mjodonnell5/ECE477-SeniorDesign-7/EInkDisplay-PCB/ECE477-SeniorDesign/ECE477-SeniorDesign.kicad_pcb

## KiCad design EInkDisplay-PCB/ECE477-SeniorDesign/ECE477-SeniorDesign.kicad_pcb (2025-03-13)

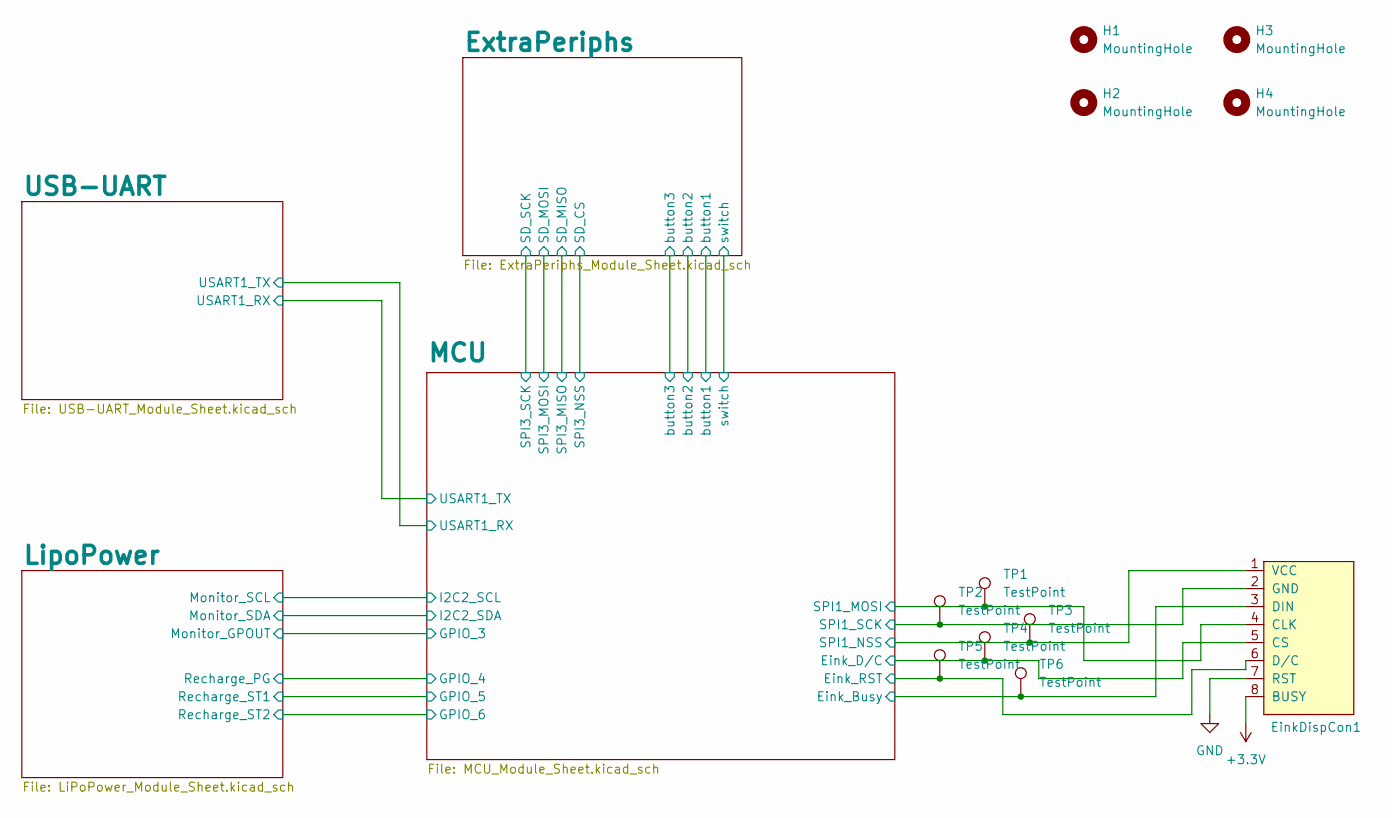
[picture p1: schematic ECE477-SeniorDesign.kicad_sch]

Parts:
EinkDispCon1: PinHeader_1x08_P2.54mm_Vertical
H1, H2, H3, H4: MountingHole; MountingHole_2.1mm
TP1, TP2, TP3, TP4, TP5, TP6: TestPoint; TestPoint_Pad_D2.0mm

Connections:
+3.3V: EinkDispCon1.8 (BUSY); also elsewhere on the board
/MCU/Eink_Busy: EinkDispCon1.3 (DIN), TP6.1; also elsewhere on the board
/MCU/Eink_D/C: EinkDispCon1.5 (CS), TP4.1; also elsewhere on the board
/MCU/Eink_RST: EinkDispCon1.6 (D/C), TP5.1; also elsewhere on the board
/MCU/SPI1_MOSI: EinkDispCon1.4 (CLK), TP1.1; also elsewhere on the board
/MCU/SPI1_NSS: EinkDispCon1.1 (VCC), TP3.1; also elsewhere on the board
/MCU/SPI1_SCK: EinkDispCon1.2 (GND), TP2.1; also elsewhere on the board
GND: EinkDispCon1.7 (RST); also elsewhere on the board

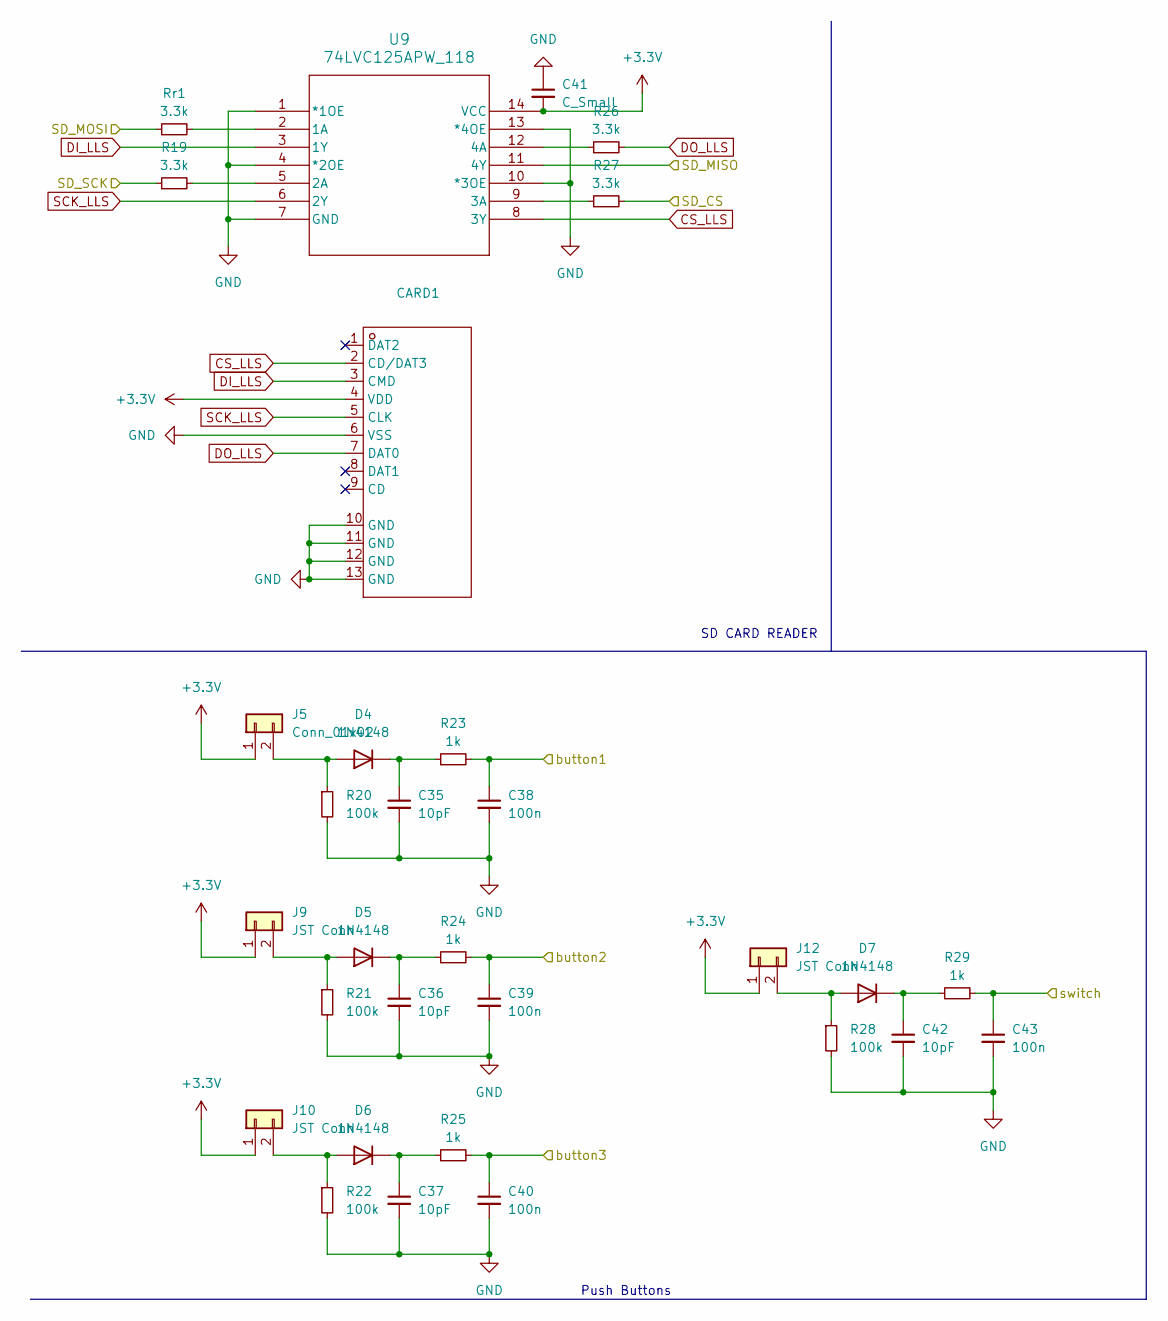
[picture p2: schematic ExtraPeriphs_Module_Sheet.kicad_sch]

Parts:
C35, C36, C37, C42: 10pF; C_0805_2012Metric_Pad1.18x1.45mm_HandSolder
C38, C39, C40, C43: 100n; C_0805_2012Metric_Pad1.18x1.45mm_HandSolder
C41: C_Small; C_0805_2012Metric_Pad1.18x1.45mm_HandSolder
CARD1: SD_reader_comp; Manufacturer Part XKTF-015-N; LCSC Part Name 自弹式 MicroSD卡(TF卡) 卡座
D4, D5, D6, D7: 1N4148; D_DO-35_SOD27_P7.62mm_Horizontal
J5: Conn_01x02; SolderWire-0.1sqmm_1x02_P3.6mm_D0.4mm_OD1mm
J9, J10, J12: JST Conn; SolderWire-0.1sqmm_1x02_P3.6mm_D0.4mm_OD1mm
R19, R26, R27: 3.3k; R_0805_2012Metric_Pad1.20x1.40mm_HandSolder
R20, R21, R22, R28: 100k; R_0805_2012Metric_Pad1.20x1.40mm_HandSolder
R23, R24, R25, R29: 1k; R_0805_2012Metric_Pad1.20x1.40mm_HandSolder
Rr1: 3.3k; R_0805_2012Metric_Pad1.20x1.40mm_HandSolder
U9: 74LVC125APW_118; 74LVC

Connections:
+3.3V: C41.2, CARD1.4 (VDD), J5.1, J9.1, J10.1, J12.1, U9.14 (VCC); also elsewhere on the board
/ExtraPeriphs/SD_CS: R27.2; also elsewhere on the board
/ExtraPeriphs/SD_MISO: U9.11 (4Y); also elsewhere on the board
/ExtraPeriphs/SD_MOSI: Rr1.1; also elsewhere on the board
/ExtraPeriphs/SD_SCK: R19.1; also elsewhere on the board
/ExtraPeriphs/button1: C38.1, R23.2; also elsewhere on the board
/ExtraPeriphs/button2: C39.1, R24.2; also elsewhere on the board
/ExtraPeriphs/button3: C40.1, R25.2; also elsewhere on the board
/ExtraPeriphs/switch: C43.1, R29.2; also elsewhere on the board
CS_LLS: CARD1.2 (CD/DAT3), U9.8 (3Y)
DI_LLS: CARD1.3 (CMD), U9.3 (1Y)
DO_LLS: CARD1.7 (DAT0), R26.2
GND: C35.2, C36.2, C37.2, C38.2, C39.2, C40.2, C41.1, C42.2, C43.2, CARD1.6 (VSS), CARD1.10 (GND), CARD1.11 (GND), CARD1.12 (GND), CARD1.13 (GND), R20.2, R21.2, R22.2, R28.2, U9.1 (*1OE), U9.4 (*2OE), U9.7 (GND), U9.10 (*3OE), U9.13 (*4OE); also elsewhere on the board
unnamed: D4.2 (A), J5.2, R20.1
unnamed: C35.1, D4.1 (K), R23.1
unnamed: D5.2 (A), J9.2, R21.1
unnamed: C36.1, D5.1 (K), R24.1
unnamed: D6.2 (A), J10.2, R22.1
unnamed: C37.1, D6.1 (K), R25.1
unnamed: D7.2 (A), J12.2, R28.1
unnamed: C42.1, D7.1 (K), R29.1
unnamed: Rr1.2, U9.2 (1A)
unnamed: R19.2, U9.5 (2A)
unnamed: R27.1, U9.9 (3A)
unnamed: R26.1, U9.12 (4A)
SCK_LLS: CARD1.5 (CLK), U9.6 (2Y)

Notes on the sheet:
SD CARD READER
Push Buttons

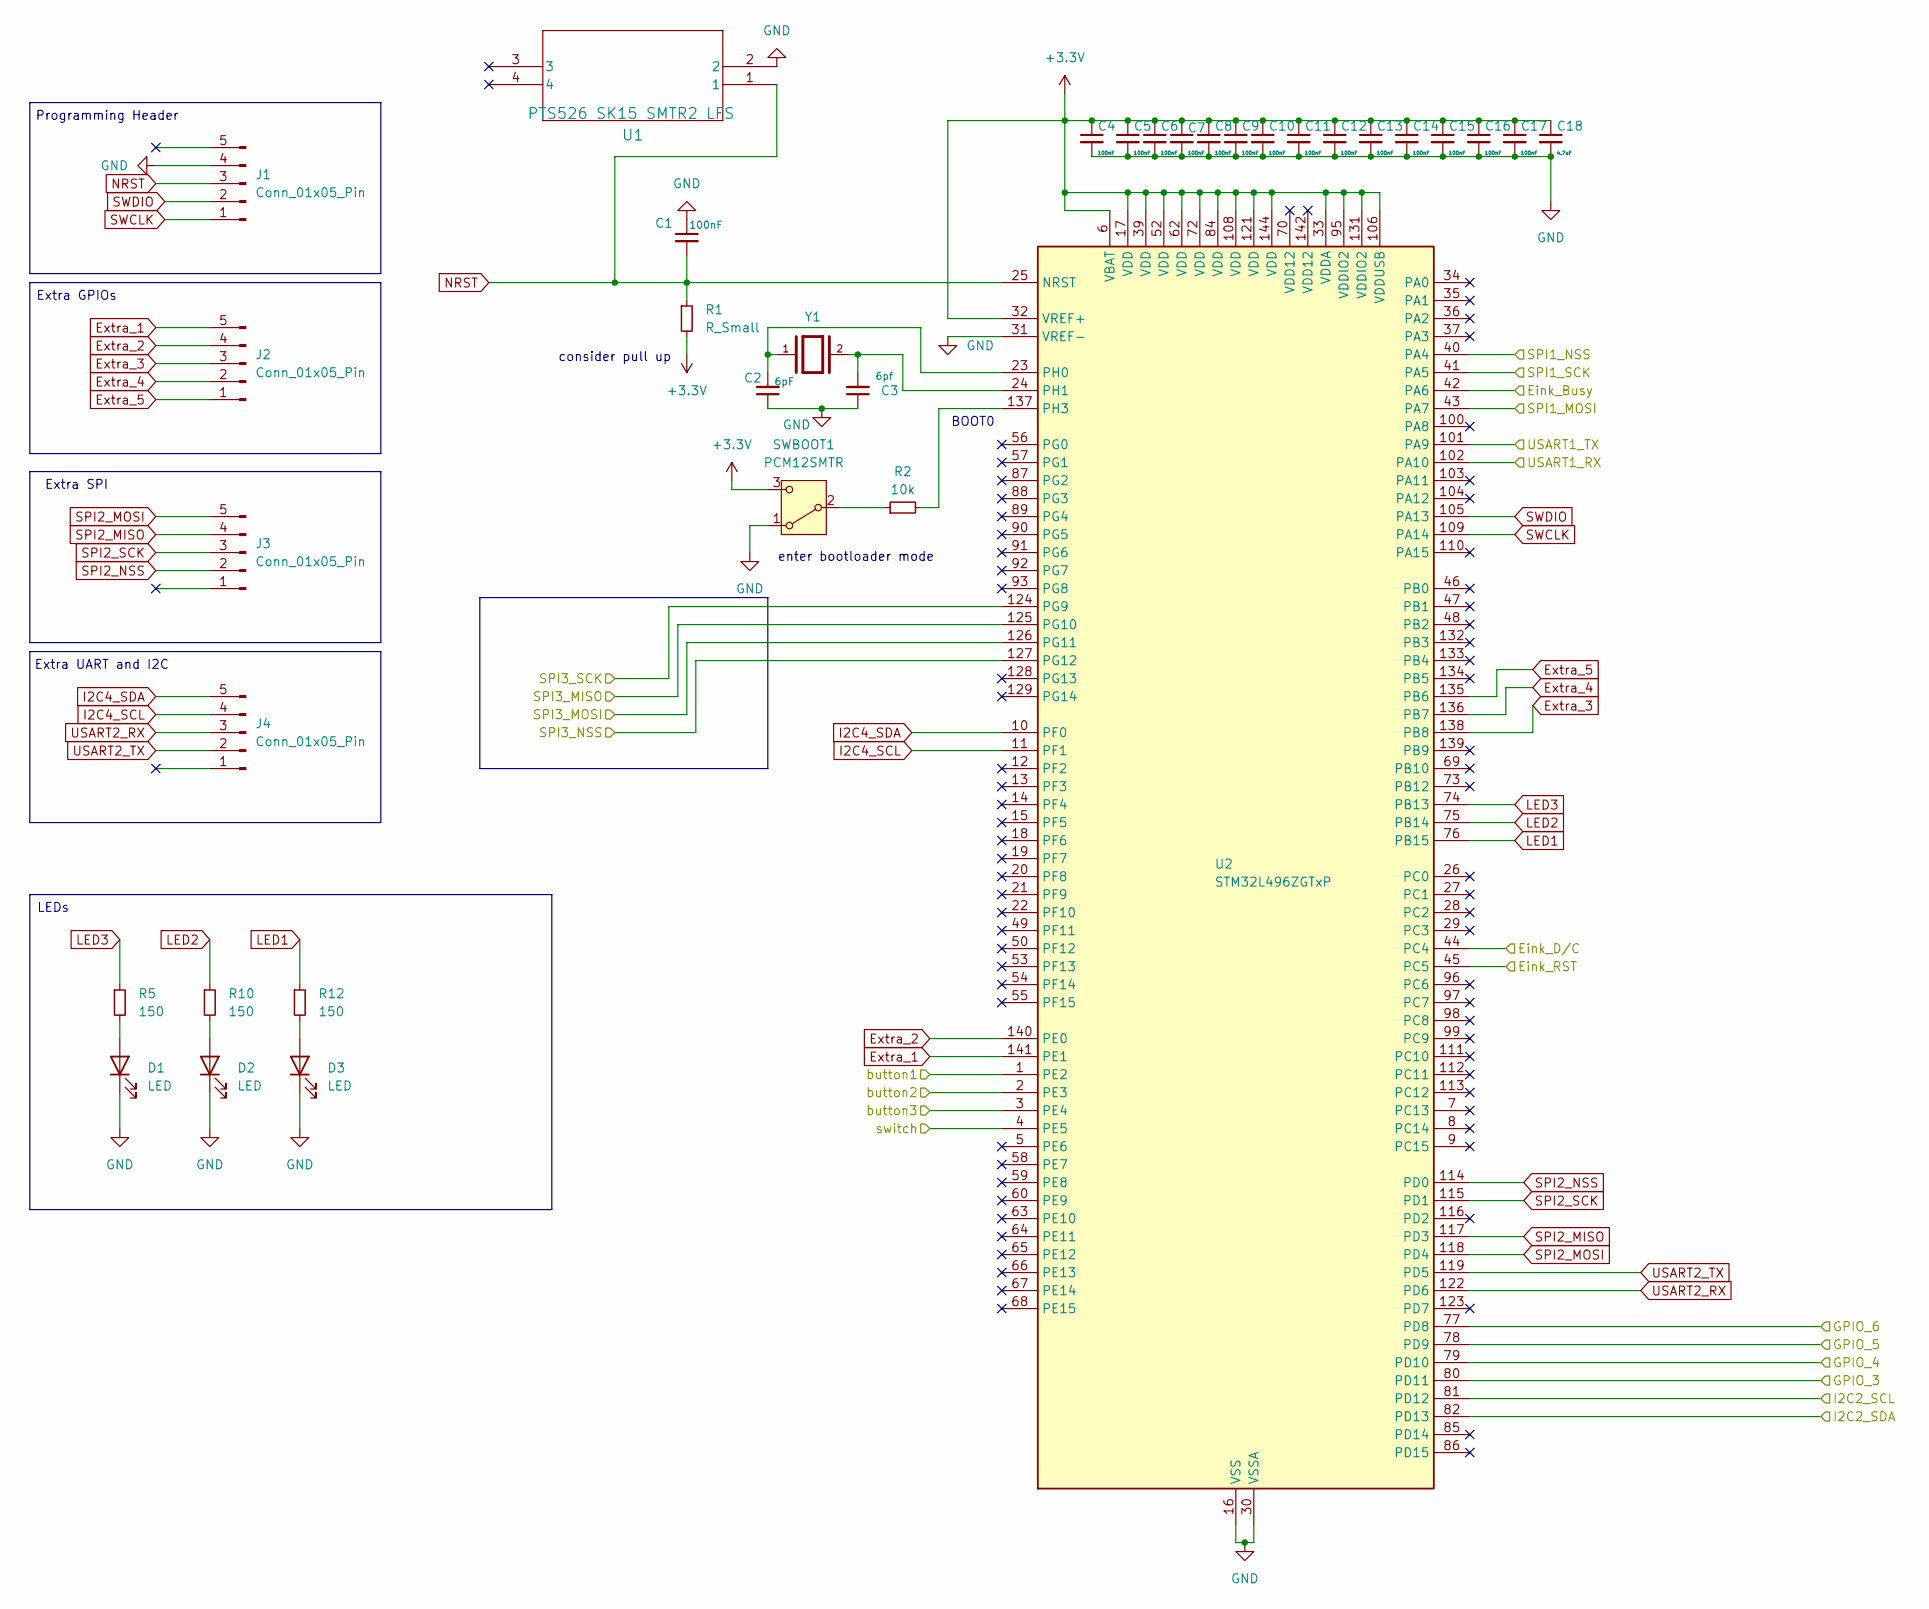
[picture p3: schematic MCU_Module_Sheet.kicad_sch]

Parts:
C1, C4, C5, C6, C7, C8, C9, C10, C11, C12, C13, C14, C15, C16, C17: 100nF; C_0805_2012Metric_Pad1.18x1.45mm_HandSolder
C2: 6pF; C_0805_2012Metric_Pad1.18x1.45mm_HandSolder
C3: 6pf; C_0805_2012Metric_Pad1.18x1.45mm_HandSolder
C18: 4.7uF; C_0805_2012Metric_Pad1.18x1.45mm_HandSolder
D1, D2, D3: LED; LED_0603_1608Metric
J1, J2, J3, J4: Conn_01x05_Pin; PinHeader_1x05_P2.54mm_Vertical
R1: R_Small; R_0805_2012Metric_Pad1.20x1.40mm_HandSolder
R2: 10k; R_0603_1608Metric_Pad0.98x0.95mm_HandSolder
R5, R10, R12: 150; R_0805_2012Metric_Pad1.20x1.40mm_HandSolder
SWBOOT1: PCM12SMTR; SW_SPDT_PCM12
U1: PTS526 SK15 SMTR2 LFS; PTS256
U2: STM32L496ZGTxP; LQFP-144_20x20mm_P0.5mm
Y1: CM9V-T1A-32.768KHZ-7PF-100PPM-TA-QC; PARTREV 8.0/10.2016

Connections:
+3.3V: C4.1, C5.1, C6.1, C7.1, C8.1, C9.1, C10.1, C11.1, C12.1, C13.1, C14.1, C15.1, C16.1, C17.1, C18.1, R1.2, SWBOOT1.3 (C), U2.6 (VBAT), U2.17 (VDD), U2.32 (VREF+), U2.33 (VDDA), U2.39 (VDD), U2.52 (VDD), U2.62 (VDD), U2.72 (VDD), U2.84 (VDD), U2.95 (VDDIO2), U2.106 (VDDUSB), U2.108 (VDD), U2.121 (VDD), U2.131 (VDDIO2), U2.144 (VDD); also elsewhere on the board
/ExtraPeriphs/SD_CS: U2.127 (PG12); also elsewhere on the board
/ExtraPeriphs/SD_MISO: U2.125 (PG10); also elsewhere on the board
/ExtraPeriphs/SD_MOSI: U2.126 (PG11); also elsewhere on the board
/ExtraPeriphs/SD_SCK: U2.124 (PG9); also elsewhere on the board
/ExtraPeriphs/button1: U2.1 (PE2); also elsewhere on the board
/ExtraPeriphs/button2: U2.2 (PE3); also elsewhere on the board
/ExtraPeriphs/button3: U2.3 (PE4); also elsewhere on the board
/ExtraPeriphs/switch: U2.4 (PE5); also elsewhere on the board
/LipoPower/Monitor_GPOUT: U2.80 (PD11); also elsewhere on the board
/LipoPower/Monitor_SCL: U2.81 (PD12); also elsewhere on the board
/LipoPower/Monitor_SDA: U2.82 (PD13); also elsewhere on the board
/LipoPower/Recharge_PG: U2.79 (PD10); also elsewhere on the board
/LipoPower/Recharge_ST1: U2.78 (PD9); also elsewhere on the board
/LipoPower/Recharge_ST2: U2.77 (PD8); also elsewhere on the board
/MCU/Eink_Busy: U2.42 (PA6); also elsewhere on the board
/MCU/Eink_D/C: U2.44 (PC4); also elsewhere on the board
/MCU/Eink_RST: U2.45 (PC5); also elsewhere on the board
/MCU/SPI1_MOSI: U2.43 (PA7); also elsewhere on the board
/MCU/SPI1_NSS: U2.40 (PA4); also elsewhere on the board
/MCU/SPI1_SCK: U2.41 (PA5); also elsewhere on the board
/MCU/USART1_RX: U2.102 (PA10); also elsewhere on the board
/MCU/USART1_TX: U2.101 (PA9); also elsewhere on the board
Extra_1: J2.5, U2.141 (PE1)
Extra_2: J2.4, U2.140 (PE0)
Extra_3: J2.3, U2.138 (PB8)
Extra_4: J2.2, U2.136 (PB7)
Extra_5: J2.1, U2.135 (PB6)
GND: C1.1, C2.1, C3.1, C4.2, C5.2, C6.2, C7.2, C8.2, C9.2, C10.2, C11.2, C12.2, C13.2, C14.2, C15.2, C16.2, C17.2, C18.2, D1.1 (K), D2.1 (K), D3.1 (K), J1.4, SWBOOT1.1 (A), U1.2, U2.16 (VSS), U2.30 (VSSA), U2.31 (VREF-), U2.38 (VSS), U2.51 (VSS), U2.61 (VSS), U2.71 (VSS), U2.83 (VSS), U2.94 (VSS), U2.107 (VSS), U2.120 (VSS), U2.130 (VSS), U2.143 (VSS); also elsewhere on the board
I2C4_SCL: J4.4, U2.11 (PF1)
I2C4_SDA: J4.5, U2.10 (PF0)
LED1: R12.1, U2.76 (PB15)
LED2: R10.1, U2.75 (PB14)
LED3: R5.1, U2.74 (PB13)
NRST: C1.2, J1.3, R1.1, U1.1, U2.25 (NRST)
unnamed: D1.2 (A), R5.2
unnamed: D2.2 (A), R10.2
unnamed: D3.2 (A), R12.2
unnamed: R2.1, SWBOOT1.2 (B)
unnamed: C2.2, U2.23 (PH0), Y1.1
unnamed: C3.2, U2.24 (PH1), Y1.2
unnamed: R2.2, U2.137 (PH3)
SPI2_MISO: J3.4, U2.117 (PD3)
SPI2_MOSI: J3.5, U2.118 (PD4)
SPI2_NSS: J3.2, U2.114 (PD0)
SPI2_SCK: J3.3, U2.115 (PD1)
SWCLK: J1.1, U2.109 (PA14)
SWDIO: J1.2, U2.105 (PA13)
USART2_RX: J4.3, U2.122 (PD6)
USART2_TX: J4.2, U2.119 (PD5)

Notes on the sheet:
consider pull up
BOOT0
Extra UART and I2C
Programming Header
enter bootloader mode
Extra SPI
Extra GPIOs
LEDs

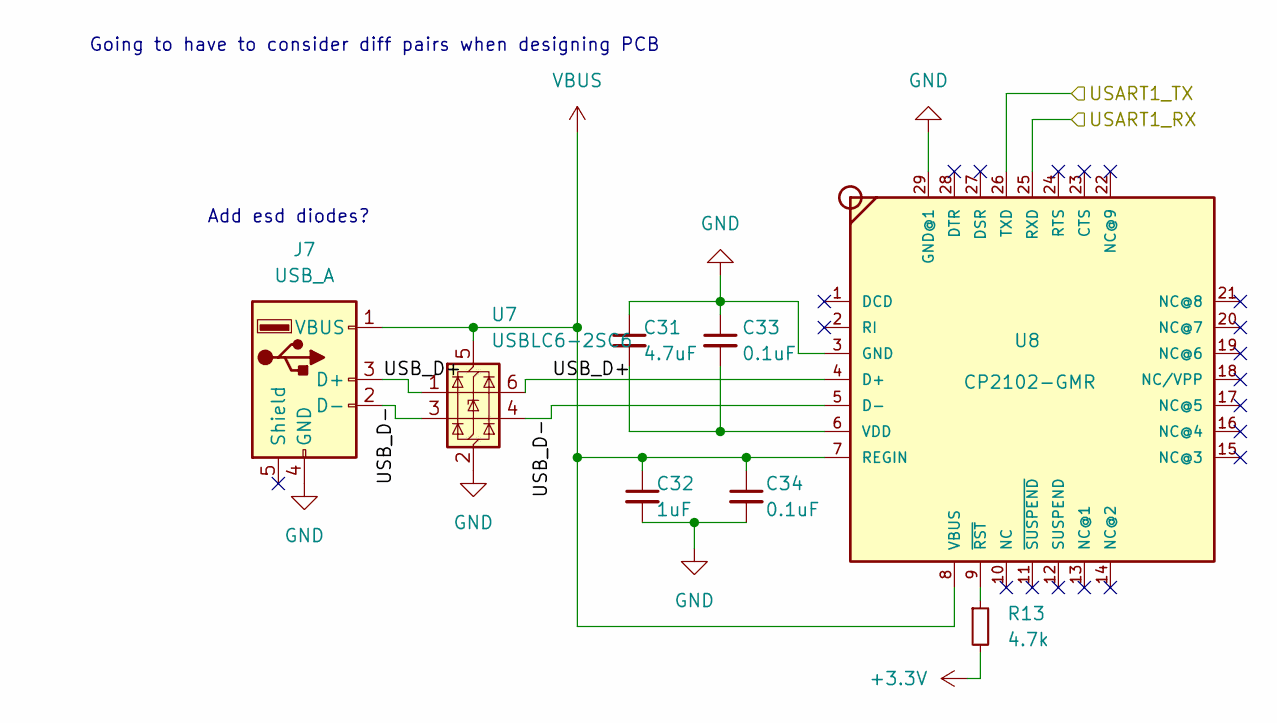
[picture p4: schematic USB-UART_Module_Sheet.kicad_sch]

Parts:
C31: 4.7uF; C_0805_2012Metric_Pad1.18x1.45mm_HandSolder
C32: 1uF; C_0805_2012Metric_Pad1.18x1.45mm_HandSolder
C33, C34: 0.1uF; C_0805_2012Metric_Pad1.18x1.45mm_HandSolder
J7: USB_A; USB_A_Receptacle_GCT_USB1046
R13: 4.7k; R_0805_2012Metric_Pad1.20x1.40mm_HandSolder
U7: USBLC6-2SC6; SOT-23-6
U8: CP2102-GMR; CP2102; MPN CP2102-GMR; LCSC C6568

Connections:
+3.3V: R13.2; also elsewhere on the board
/MCU/USART1_RX: U8.26 (TXD); also elsewhere on the board
/MCU/USART1_TX: U8.25 (RXD); also elsewhere on the board
/USB-UART/USB_D+: J7.3 (D+), U7.1 (I/O1), U7.6 (I/O1), U8.4 (D+)
/USB-UART/USB_D-: J7.2 (D-), U7.3 (I/O2), U7.4 (I/O2), U8.5 (D-)
GND: C31.1, C32.2, C33.1, C34.2, J7.4 (GND), J7.5 (Shield), U7.2 (GND), U8.3 (GND), U8.29 (GND@1); also elsewhere on the board
unnamed: C31.2, C33.2, U8.6 (VDD)
unnamed: R13.1, U8.9 (~RST)
VBUS: C32.1, C34.1, J7.1 (VBUS), U7.5 (VBUS), U8.7 (REGIN), U8.8 (VBUS); also elsewhere on the board

Notes on the sheet:
Add esd diodes?
Going to have to consider diff pairs when designing PCB

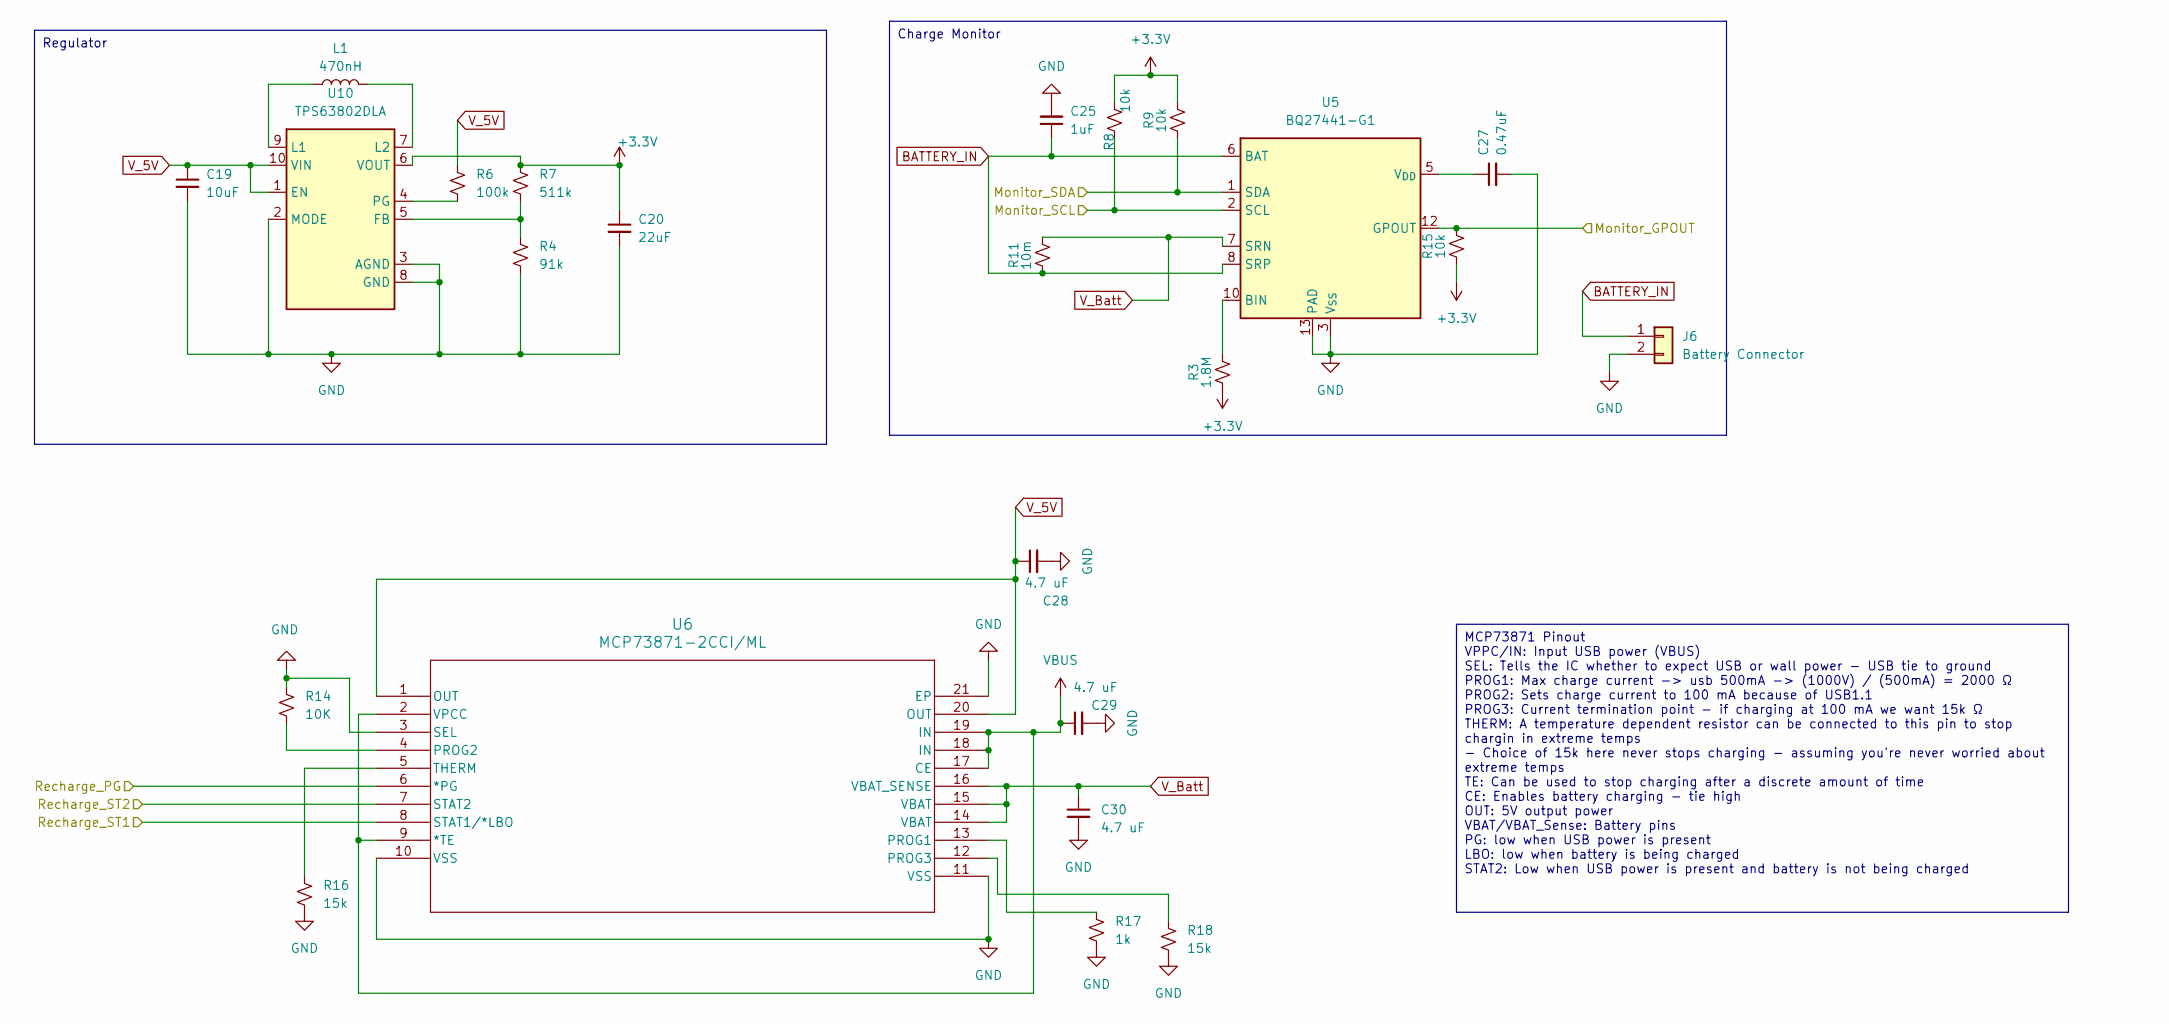
[picture p5: schematic LiPoPower_Module_Sheet.kicad_sch]

Parts:
C19: 10uF; C_0805_2012Metric_Pad1.18x1.45mm_HandSolder
C20: 22uF; C_0805_2012Metric_Pad1.18x1.45mm_HandSolder
C25: 1uF; C_0805_2012Metric_Pad1.18x1.45mm_HandSolder
C27: 0.47uF; C_0805_2012Metric_Pad1.18x1.45mm_HandSolder
C28, C29, C30: 4.7 uF; C_0805_2012Metric_Pad1.18x1.45mm_HandSolder
J6: Battery Connector; JST_PH_S2B-PH-SM4-TB_1x02-1MP_P2.00mm_Horizontal
L1: 470nH; IND_XFL4015_COC-L
R3: 1.8M; R_0805_2012Metric_Pad1.20x1.40mm_HandSolder
R4: 91k; R_0805_2012Metric_Pad1.20x1.40mm_HandSolder
R6: 100k; R_0805_2012Metric_Pad1.20x1.40mm_HandSolder
R7: 511k; R_0805_2012Metric_Pad1.20x1.40mm_HandSolder
R8, R9, R15: 10k; R_0805_2012Metric_Pad1.20x1.40mm_HandSolder
R11: 10m; R_0805_2012Metric_Pad1.20x1.40mm_HandSolder
R14: 10K; R_0805_2012Metric_Pad1.20x1.40mm_HandSolder
R16, R18: 15k; R_0805_2012Metric_Pad1.20x1.40mm_HandSolder
R17: 1k; R_0805_2012Metric_Pad1.20x1.40mm_HandSolder
U5: BQ27441-G1; Texas_S-PDSO-N12
U6: MCP73871-2CCI/ML; MCP73871; LCSC C5121473
U10: TPS63802DLA; TPS63802DLR; LCSC C2845237

Connections:
+3.3V: C20.1, R3.1, R7.1, R8.2, R9.2, R15.1, U10.6 (VOUT); also elsewhere on the board
/LipoPower/Monitor_GPOUT: R15.2, U5.12 (GPOUT); also elsewhere on the board
/LipoPower/Monitor_SCL: R8.1, U5.2 (SCL); also elsewhere on the board
/LipoPower/Monitor_SDA: R9.1, U5.1 (SDA); also elsewhere on the board
/LipoPower/Recharge_PG: U6.6 (*PG); also elsewhere on the board
/LipoPower/Recharge_ST1: U6.8 (STAT1/*LBO); also elsewhere on the board
/LipoPower/Recharge_ST2: U6.7 (STAT2); also elsewhere on the board
BATTERY_IN: C25.1, J6.1, R11.1, U5.6 (BAT), U5.8 (SRP)
GND: C19.2, C20.2, C25.2, C27.2, C28.2, C29.2, C30.2, J6.2, R4.2, R14.1, R16.1, R17.2, R18.1, U5.3 (V_{SS}), U5.13 (PAD), U6.3 (SEL), U6.10 (VSS), U6.11 (VSS), U6.21 (EP), U10.2 (MODE), U10.3 (AGND), U10.8 (GND); also elsewhere on the board
unnamed: R3.2, U5.10 (BIN)
unnamed: C27.1, U5.5 (V_{DD})
unnamed: R17.1, U6.13 (PROG1)
unnamed: R14.2, U6.4 (PROG2)
unnamed: R18.2, U6.12 (PROG3)
unnamed: R16.2, U6.5 (THERM)
unnamed: R4.1, R7.2, U10.5 (FB)
unnamed: L1.1, U10.9 (L1)
unnamed: L1.2, U10.7 (L2)
unnamed: R6.1, U10.4 (PG)
VBUS: C29.1, U6.2 (VPCC), U6.9 (*TE), U6.17 (CE), U6.18 (IN), U6.19 (IN); also elsewhere on the board
V_5V: C19.1, C28.1, R6.2, U6.1 (OUT), U6.20 (OUT), U10.1 (EN), U10.10 (VIN)
V_Batt: C30.1, R11.2, U5.7 (SRN), U6.14 (VBAT), U6.15 (VBAT), U6.16 (VBAT_SENSE)

Notes on the sheet:
Charge Monitor
MCP73871 Pinout VPPC/IN: Input USB power (VBUS) SEL: Tells the IC whether to expect USB or wall power - USB tie to ground PROG1: Max charge current -> usb 500mA -> (1000V) / (500mA) = 2000 Ω PROG2: Sets charge current to 100 mA because of USB1.1 PROG3: Current termination point - if charging at 100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
Regulator

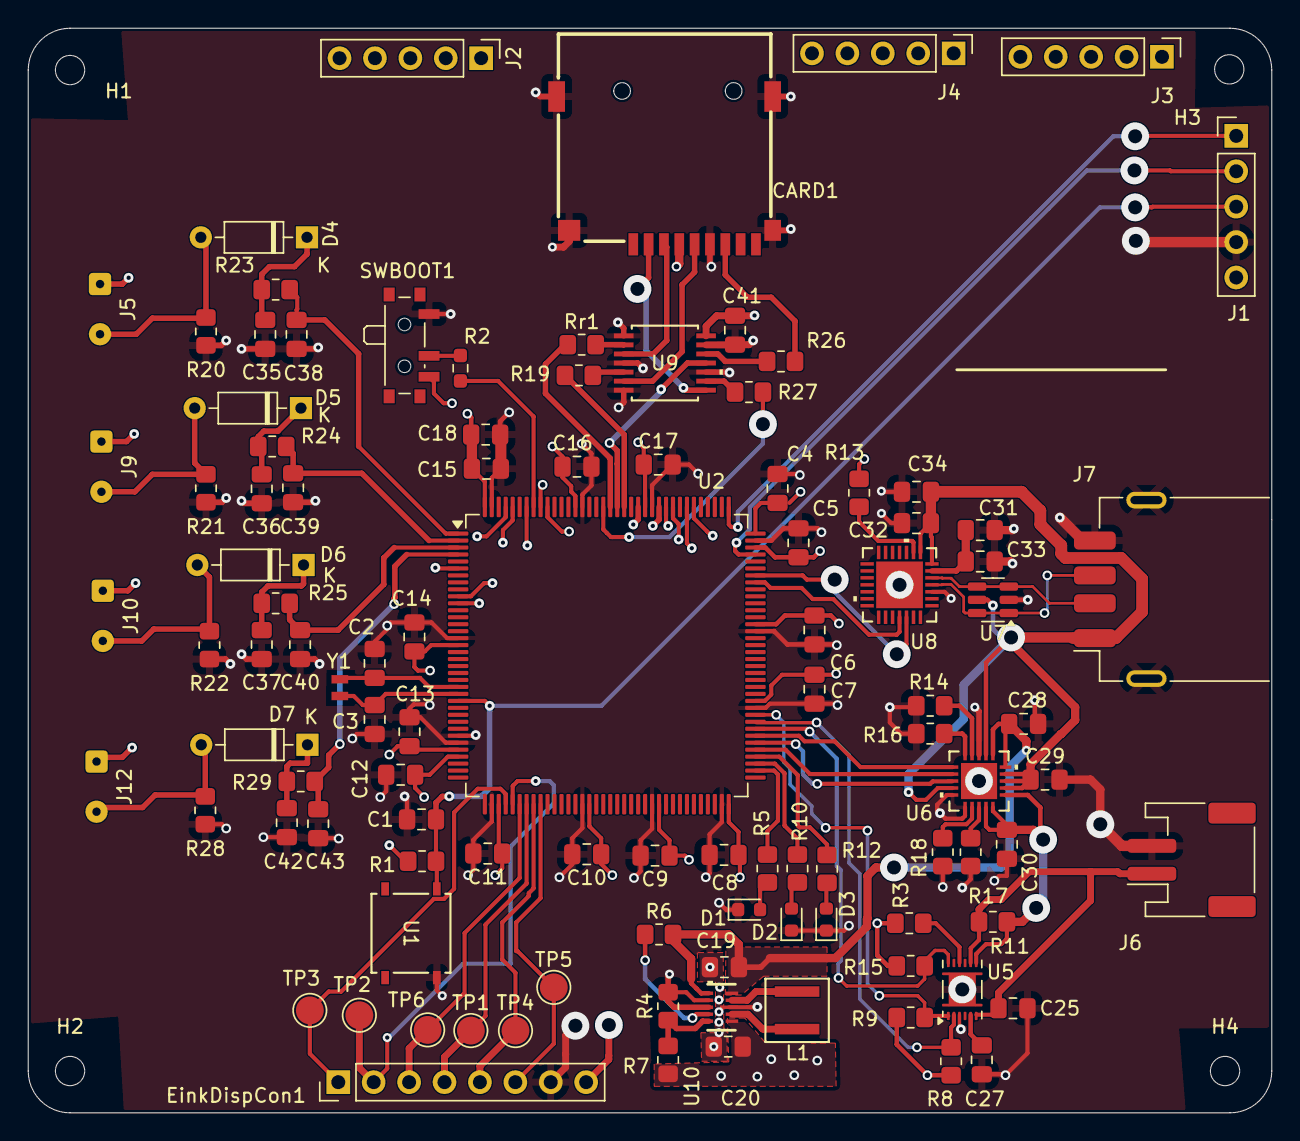
[picture p6: board ECE477-SeniorDesign.kicad_pcb from above]

Board: 4 copper layers, 89.2 x 77.8 mm, 108 parts (0 on the bottom side), 84 nets.
