mjodonnell5/ECE477-SeniorDesign-7/firmware/include/handlers.h

#ifndef HANDLERS_H
#define HANDLERS_H

void none();

void home_sel_short();
void home_down_short();
void home_up_short();

void deck_sel_short();
void deck_sel_long();
void deck_down_short();
void deck_down_long();
void deck_up_short();

void delete_sel_long();
void delete_down_long();

void settings_sel_short();
void settings_down_short();
void settings_down_long();
void settings_up_short();

void flashcard_sel_short();
void flashcard_down_short();
void flashcard_down_long();
void flashcard_up_short();

#endif /* HANDLERS_H */
