mjodonnell5/ECE477-SeniorDesign-7/firmware/src/spi.c

#include <stm32l496xx.h>
#include <stdint.h>
#include <stddef.h>

#include "../include/clock.h"

/* For e-ink */
void spi1_init()
{
    RCC->AHB2ENR |= RCC_AHB2ENR_GPIOAEN;
    RCC->APB2ENR |= RCC_APB2ENR_SPI1EN;

    /* CS = PA4 (OUTPUT), SCK = PA5 (AF), MOSI = PA7 (AF) */

    GPIOA->MODER &= ~(GPIO_MODER_MODER4 | GPIO_MODER_MODER5 | GPIO_MODER_MODER7);
    GPIOA->MODER |= (GPIO_MODER_MODER4_0 | GPIO_MODER_MODER5_1 | GPIO_MODER_MODER7_1);

    /* High speed */
    GPIOA->OSPEEDR &= ~(GPIO_OSPEEDR_OSPEED4 | GPIO_OSPEEDR_OSPEED5 | GPIO_OSPEEDR_OSPEED7);
    GPIOA->OSPEEDR |= GPIO_OSPEEDR_OSPEED4_1 | GPIO_OSPEEDR_OSPEED5_1 | GPIO_OSPEEDR_OSPEED7_1;

    /* AF5 */
    GPIOA->AFR[0] &= ~(GPIO_AFRL_AFSEL5 | GPIO_AFRL_AFSEL7);
    GPIOA->AFR[0] |= (GPIO_AFRL_AFSEL5_0 | GPIO_AFRL_AFSEL5_2
                    | GPIO_AFRL_AFSEL7_0 | GPIO_AFRL_AFSEL7_2);

    SPI1->CR1 &= ~(SPI_CR1_SPE);

    SPI1->CR1 &= ~SPI_CR1_BR;

    /* 8 bit word size */
    SPI1->CR2 &= ~SPI_CR2_DS_3;
    SPI1->CR2 |= (SPI_CR2_DS_2 | SPI_CR2_DS_1 | SPI_CR2_DS_0);

    /* RXNE generation for 8-bit */
    SPI1->CR2 |= SPI_CR2_FRXTH;

    /* Software controlled CS */
    SPI1->CR1 |= SPI_CR1_SSM | SPI_CR1_SSI;

    SPI1->CR1 |= SPI_CR1_MSTR;

    SPI1->CR1 |= SPI_CR1_SPE;

}

void spi_tx(SPI_TypeDef* spi, uint8_t data)
{
    while (!(spi->SR & SPI_SR_TXE));

    /* Force to 8-bit */
    *((volatile uint8_t*)&spi->DR) = data;

    while (spi->SR & SPI_SR_BSY);
}

void spi_rx(SPI_TypeDef* spi, uint8_t* data)
{
    while (!(spi->SR & SPI_SR_RXNE));

    *data = spi->DR;
}

void spi_tx_buffer(SPI_TypeDef* spi, uint8_t* data, size_t size)
{
    for (size_t i = 0; i < size; ++size) {
        while (!(spi->SR & SPI_SR_TXE));

        /* Force to 8-bit */
        *((volatile uint8_t*)&spi->DR) = data[i];

        while (spi->DR & SPI_SR_BSY);
    }
}

void spi_rx_buffer(SPI_TypeDef* spi, uint8_t* data, size_t size)
{
    for (size_t i = 0; i < size; ++size) {
        while (!(spi->SR & SPI_SR_RXNE));

        data[i] = spi->DR;
    }
}
