mjodonnell5/ECE477-SeniorDesign-7/(commit log)

2025-01-16 Add Blocks
    Adding USB-UART block
    [ECE477-SeniorDesign.kicad_sch]
2025-01-28 Pushing some basic SPI stuff, init is not setup for epaper at the moment and is just copied from 362
2025-01-28 I think SPI config for eink should be good
2025-01-28 switching over to V2
2025-01-28 Adding Power Sheet
    [PowerSheet.kicad_sch]
2025-01-28 Adding Component Library
    -named einkcomponent library
    [ECE477-SeniorDesign.kicad_sch, EDPDriverSheet.kicad_sch, PowerSheet.kicad_sch]
2025-01-28 Trying to add some drawing functions and rendering the framebuffer
2025-01-30 USB Complete
    [ECE477-SeniorDesign.kicad_sch]
2025-01-30 Pushing because its broken :(
    [eink.c, eink.h, main.c, spi.c]
2025-01-30 Lot of changes
    [ECE477-SeniorDesign.kicad_sch, EDPDriverSheet.kicad_sch, ExtraPeriphs_Module_Sheet.kicad_sch, LiPoPower_Module_Sheet.kicad_sch, MCU_Module_Sheet.kicad_sch, USB-UART_Module_Sheet.kicad_sch]
2025-02-04 Adding SD
    [ECE477-SeniorDesign.kicad_sch, MCU_Module_Sheet.kicad_sch, untitled.kicad_sch]
2025-02-04 Fixing SD w SPI
    [ECE477-SeniorDesign.kicad_sch, ExtraPeriphs_Module_Sheet.kicad_sch, MCU_Module_Sheet.kicad_sch]
2025-02-12 introducing power sch
    [LiPoPower_Module_Sheet.kicad_sch]
2025-02-12 fixing things
    [ECE477-SeniorDesign.kicad_pcb, ECE477-SeniorDesign.kicad_sch, LiPoPower_Module_Sheet.kicad_sch, MCU_Module_Sheet.kicad_sch, USB-UART_Module_Sheet.kicad_sch]
2025-02-19 Update USB-UART_Module_Sheet.kicad_sch
    Add ESD diode
    [USB-UART_Module_Sheet.kicad_sch]
2025-02-19 Update ECE477-SeniorDesign.kicad_pcb
    All UART / Voltage reg components
    [ECE477-SeniorDesign.kicad_pcb]
2025-02-19 adding UART files
2025-02-19 SD_Reader Footprint
2025-02-20 Lotta changes
    [ECE477-SeniorDesign.kicad_sch, LiPoPower_Module_Sheet.kicad_sch, MCU_Module_Sheet.kicad_sch]
2025-02-20 Did a decent amount of cleanup and moved buttons so Zoe and I can integrate
2025-02-21 Scrolling, clock, delaying, all kinds of fun stuff. This PR is WAY too big lol
    [buttons.c, clock.c, eink.c, main.c, state.c, ui.c, ui.h]
2025-02-23 onto PCB
    [ECE477-SeniorDesign.kicad_pcb, LiPoPower_Module_Sheet.kicad_sch, MCU_Module_Sheet.kicad_sch, USB-UART_Module_Sheet.kicad_sch]
2025-02-23 SD card updates
    [ECE477-SeniorDesign.kicad_sch, ExtraPeriphs_Module_Sheet.kicad_sch, MCU_Module_Sheet.kicad_sch]
2025-02-23 power & power pcb layout
    [LiPoPower_Module_Sheet.kicad_sch]
2025-02-25 Ensuring file save
    [USB-UART_Module_Sheet.kicad_sch]
2025-02-25 layout and coulomb counter sch update
    [ECE477-SeniorDesign.kicad_pcb, LiPoPower_Module_Sheet.kicad_sch]
2025-02-26 pcb update
    [ECE477-SeniorDesign.kicad_pcb]
2025-02-27 whole lotta changes
    [ECE477-SeniorDesign.kicad_pcb, ECE477-SeniorDesign.kicad_sch, ExtraPeriphs_Module_Sheet.kicad_sch, MCU_Module_Sheet.kicad_sch, USB-UART_Module_Sheet.kicad_sch]
2025-02-27 We can get files over UART
2025-02-27 Layout update
    [ECE477-SeniorDesign.kicad_pcb, ECE477-SeniorDesign.kicad_sch, USB-UART_Module_Sheet.kicad_sch]
2025-02-28 Fixed clock frequency, centered string wrapping and did some cleaning up
    [clock.c, main.c, state.c, ui.c]
2025-03-03 Power Routing
    [ECE477-SeniorDesign.kicad_pcb]
2025-03-06 Regulator footprint and sch update
    [ECE477-SeniorDesign.kicad_pcb, LiPoPower_Module_Sheet.kicad_sch]
2025-03-11 Sch update
    [ECE477-SeniorDesign.kicad_pcb]
2025-03-13 rev 2
    [ECE477-SeniorDesign-B_Cu.gbr, ECE477-SeniorDesign-B_Mask.gbr, ECE477-SeniorDesign-B_Paste.gbr, ECE477-SeniorDesign-B_Silkscreen.gbr, ECE477-SeniorDesign-Edge_Cuts.gbr, ECE477-SeniorDesign-F_Cu.gbr, ECE477-SeniorDesign-F_Mask.gbr, ECE477-SeniorDesign-F_Paste.gbr]
2025-03-13 implementing state logic in regards to the long button press
2025-03-13 I am dumb and not pending the render and I had the state machine messed up, it was running too fast, need delay or to WFI
    [buttons.c, state.c]
2025-03-27 Refactor button and state machine stuff
2025-04-01 adding battery code
2025-04-02 battery changes
2025-04-03 Power stuff should work, just haven't set up power switch pinout stuff
2025-04-07 new pins uart
2025-04-17 Variable fonts, can choose dominant hand, button hints
2025-04-17 Fixed button hints for right handed mode
    [buttons.c, buttons.h, eink.c, main.c, state.c, ui.c]
